Jyot-Patel/esp32-ble-gamepad/docs/images/game.jpeg

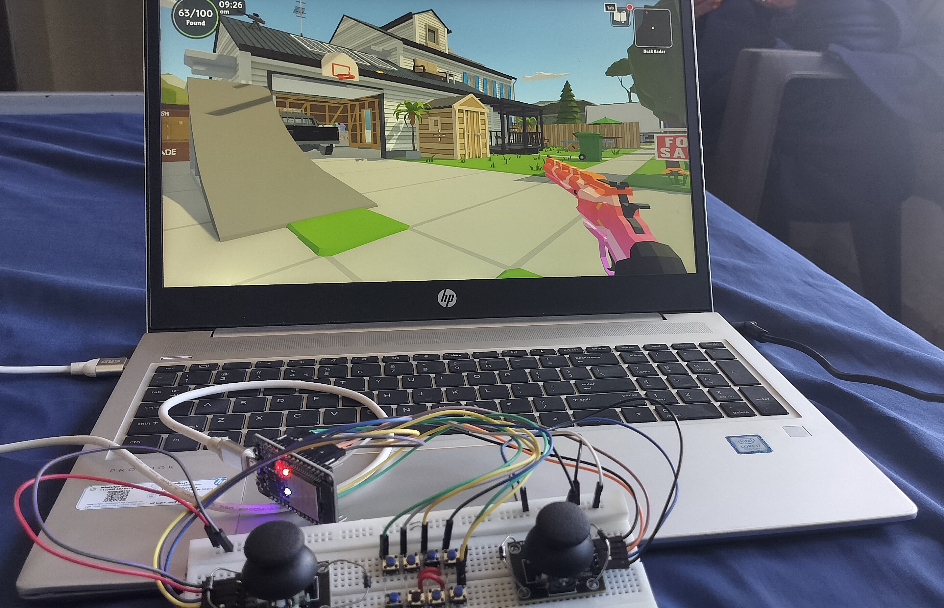
docs/images/game.jpeg
